Dyno512/OpenVFO/openvfo_nextion_teensy_4.0_eagle_cad/openvfo_nextion_teensy_4.0.png

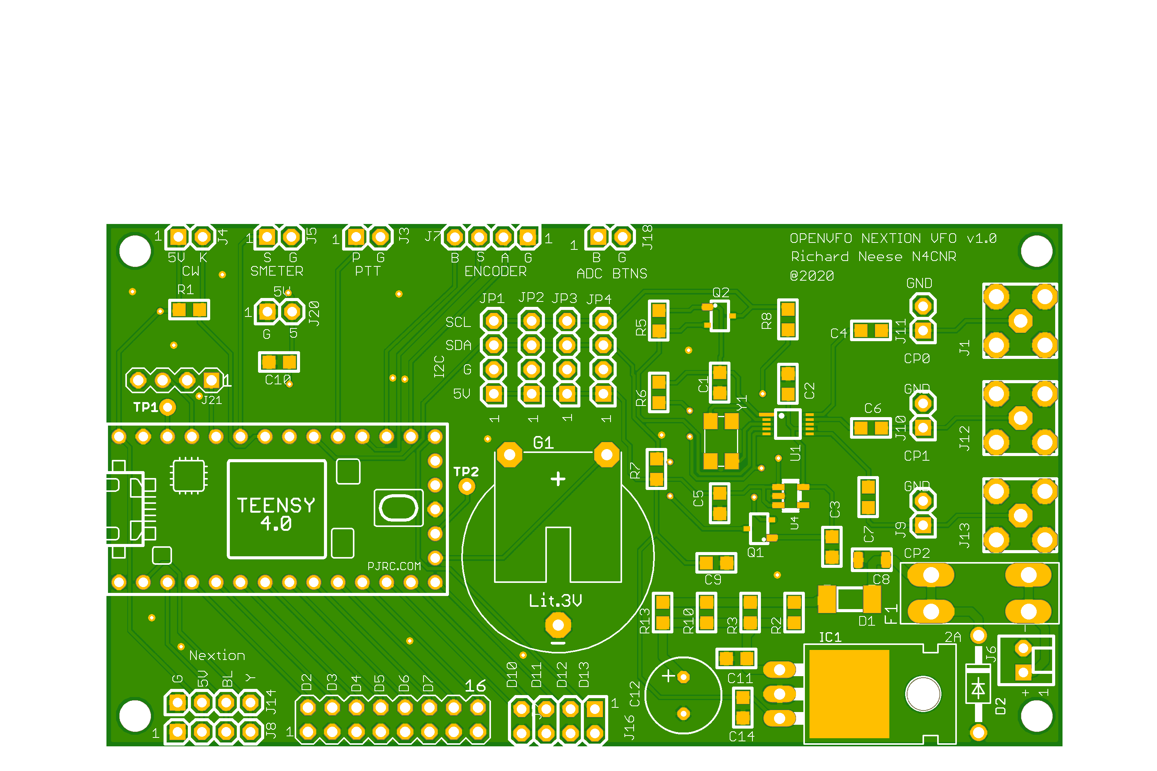
openvfo_nextion_teensy_4.0_eagle_cad/openvfo_nextion_teensy_4.0.png
