Dyno512/OpenVFO/openvfo_nextion_teensy_4.0_eagle_cad/openvfo_nextion_teensy_4.0.dxf

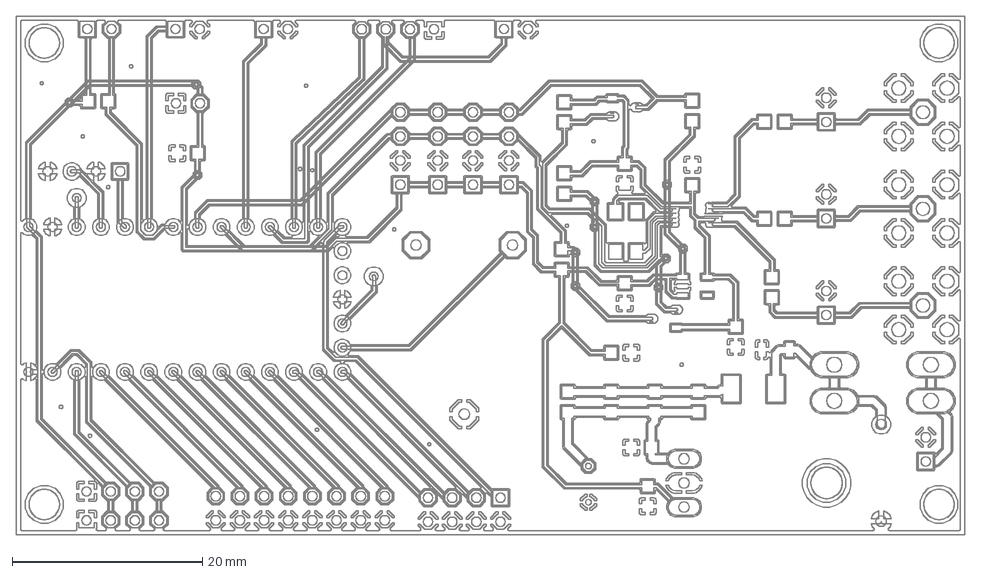
[picture p2: CAD file, 2020-04-06]
openvfo_nextion_teensy_4.0_eagle_cad/openvfo_nextion_teensy_4.0.dxf
99.7 x 54.6 mm
