Dyno512/OpenVFO/openvfo_nextion_teensy_4.0_eagle_cad/openvfo_nextion_teensy_4.0.brd

## EAGLE design openvfo_nextion_teensy_4.0_eagle_cad/openvfo_nextion_teensy_4.0.brd (2020-04-06)

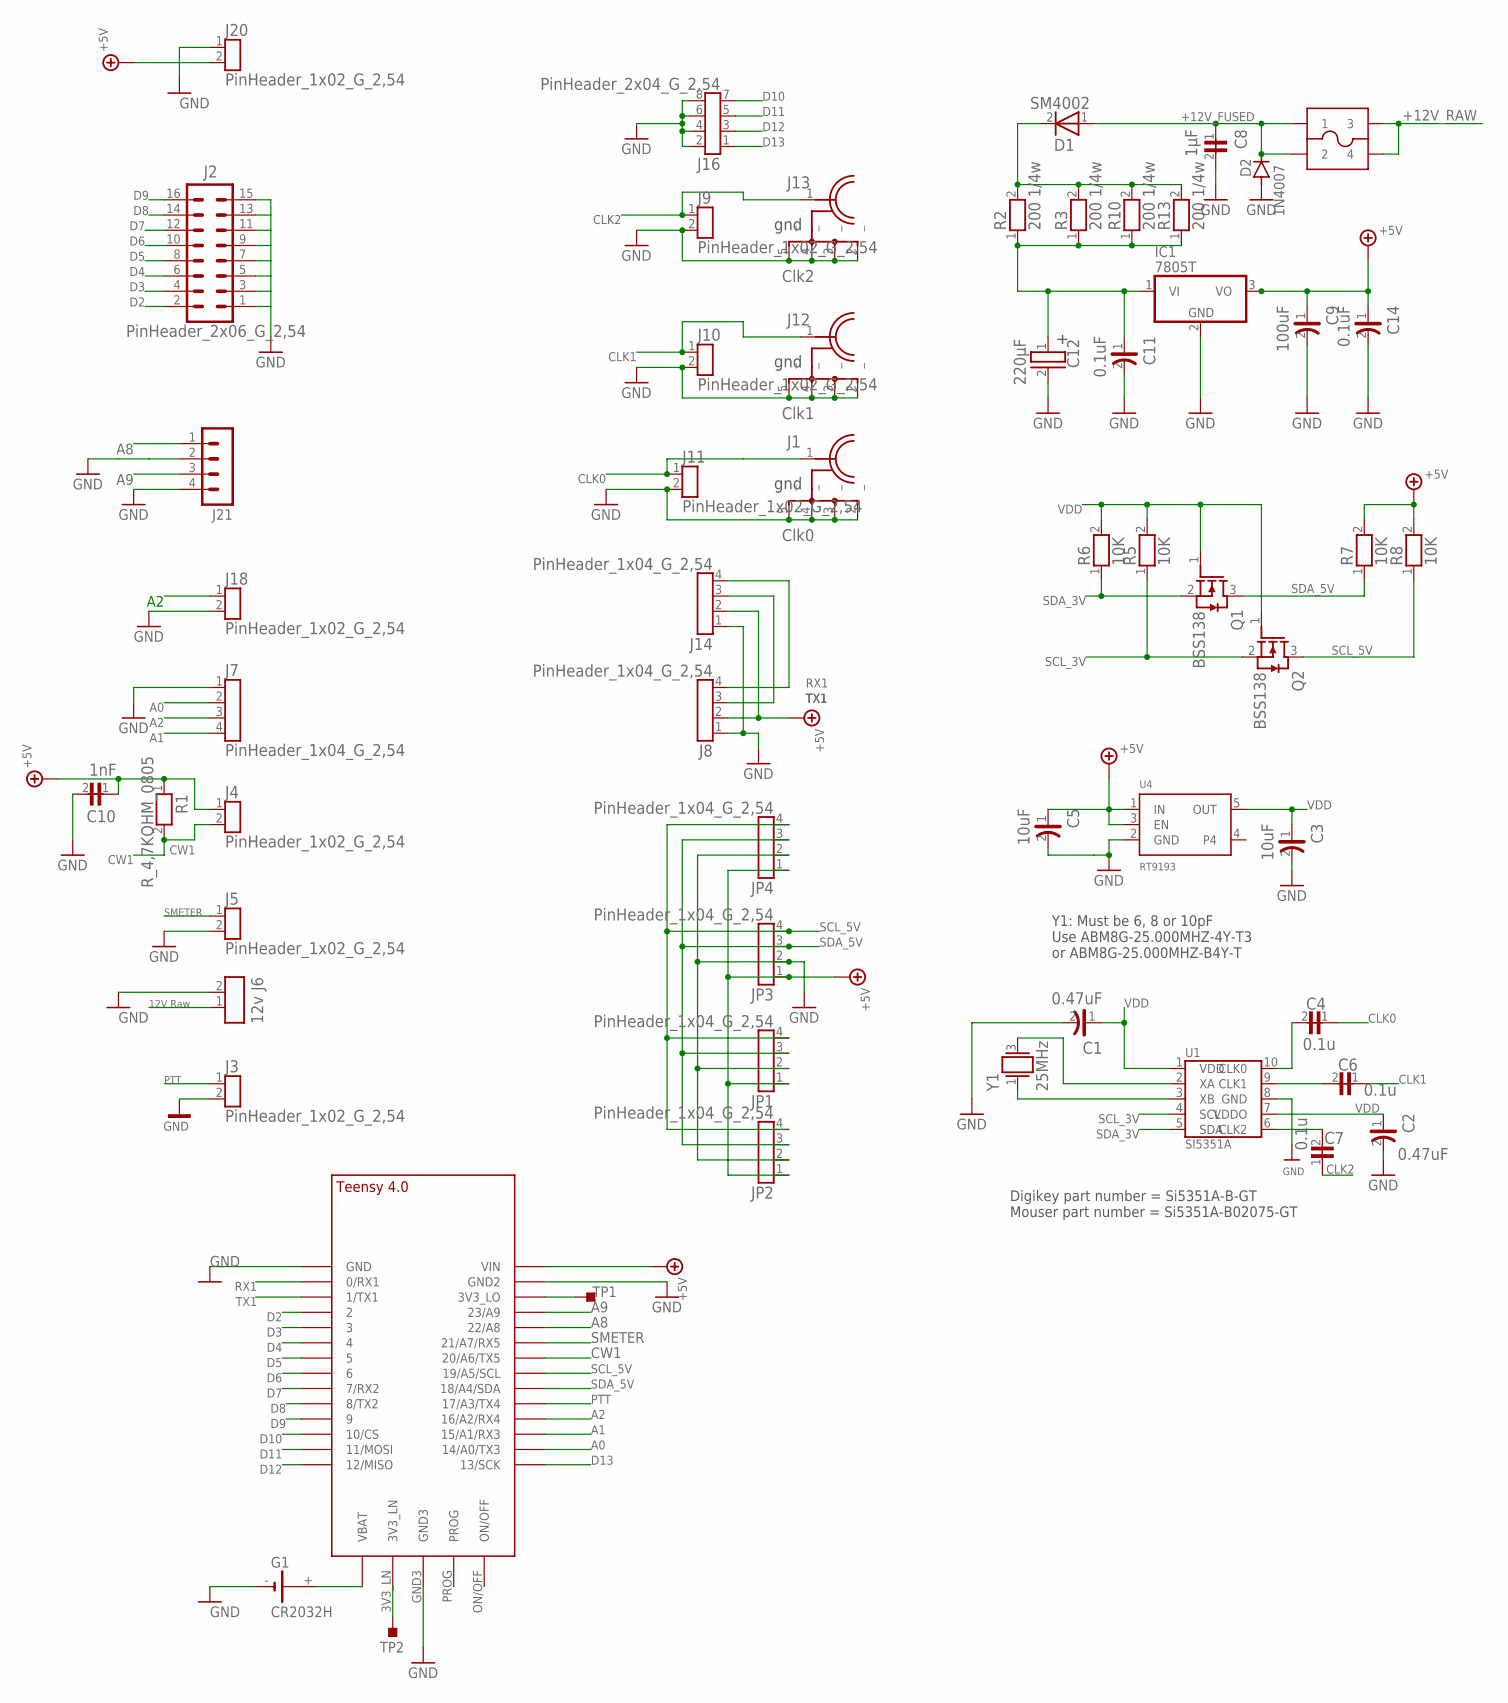
[picture p3: schematic openvfo_nextion_teensy_4.0.sch, Schematic page: 1]

Parts:
C1: 0.47uF; 0805_3
C2: 0.47uF; 0805_4
C3: 10uF; 0805_13
C4: 0.1u; 0805_81
C5: 10uF; 0805_12
C6: 0.1u; 0805_82
C7: 0.1u; 0805_83
C8: 1µF; 1206_84
C9: 100uF; 0805_95
C10: 1nF; 0805_23
C11: 0.1uF; 0805_89
C12: 220µF; D8R3,81_ELKO_104
C14: 0.1uF; 0805_96
D1: SM4002; MELF_85
D2: 1N4007; DO41-10
F1: SMALLFUSE
G1: CR2032H
IC1: 7805T; TO220H
J1: Clk0; SMA-EINBAUBUCHSE_67
J2: PinHeader_2x06_G_2,54; MA08-2
J3: PinHeader_1x02_G_2,54; STIFTLEISTE_1X02_G_2,54_17
J4: PinHeader_1x02_G_2,54; STIFTLEISTE_1X02_G_2,54_18
J5: PinHeader_1x02_G_2,54; STIFTLEISTE_1X02_G_2,54_19
J6: 12v; SL-MTA/2.54/2POL_20
J7: PinHeader_1x04_G_2,54; STIFTLEISTE_1X04_G_2,54_15
J8: PinHeader_1x04_G_2,54; STIFTLEISTE_1X04_G_2,54_22
J9: PinHeader_1x02_G_2,54; STIFTLEISTE_1X02_G_2,54_49
J10: PinHeader_1x02_G_2,54; STIFTLEISTE_1X02_G_2,54_50
J11: PinHeader_1x02_G_2,54; STIFTLEISTE_1X02_G_2,54_51
J12: Clk1; SMA-EINBAUBUCHSE_68
J13: Clk2; SMA-EINBAUBUCHSE_69
J14: PinHeader_1x04_G_2,54; STIFTLEISTE_1X04_G_2,54_70
J16: PinHeader_2x04_G_2,54; STIFTLEISTE_2X04_G_2,54_71
J18: PinHeader_1x02_G_2,54; STIFTLEISTE_1X02_G_2,54_97
J20: PinHeader_1x02_G_2,54; STIFTLEISTE_1X02_G_2,54_137
J21: MA04-1
JP1, JP2, JP3, JP4: PinHeader_1x04_G_2,54; STIFTLEISTE_1X04_G_2,54_14
Q1: BSS138; SOT23/3_7
Q2: BSS138; SOT23/3_8
R1: R_4,7KOHM_0805; 0805_21
R2: 200 1/4w; 0805_142
R3: 200 1/4w; 0805_145
R5: 10K; 0805_5
R6: 10K; 0805_6
R7: 10K; 0805_9
R8: 10K; 0805_10
R10: 200 1/4w; 0805_146
R13: 200 1/4w; 0805_147
TP1, TP2: TESTPOINT_TPS-PAD-036; TESTPOINT_PAD-036
U1: SI5351A; MSOP10/WB3X3/P0,5_0
U4: RT9193; SOT23-5_11
U$1: TEENSY_4.0
Y1: 25MHz; CFPX-104_1

Connections:
+5V: C5.1, C9.1, C10.1, C14.1, IC1.3 (VO), J4.1, J8.2, J14.2, J20.2, JP1.1, JP2.1, JP3.1, JP4.1, R1.1, R7.2, R8.2, U4.1 (IN), U4.3 (EN), U$1.VIN
+12V_FUSED: C8.1, D1.1, D2.C, F1.P$1 (1), F1.P$2 (2)
+12V_RAW: F1.P$3 (3), F1.P$4 (4), J6.1
A0: J7.2, U$1.14/A0 (14/A0/TX3)
A1: J7.4, U$1.15/A1 (15/A1/RX3)
A2: J7.3, J18.1, U$1.16/A2 (16/A2/RX4)
A8: J21.1, U$1.22/A8
A9: J21.3, U$1.23/A9
CLK0: C4.1, J1.1, J11.1
CLK1: C6.1, J10.1, J12.1
CLK2: C7.1, J9.1, J13.1
CW1: J4.2, R1.2, U$1.20/A6 (20/A6/TX5)
D2: J2.2, U$1.2
D3: J2.4, U$1.3/CANTX (3)
D4: J2.6, U$1.4/CANRX (4)
D5: J2.8, U$1.5
D6: J2.10, U$1.6
D7: J2.12, U$1.7 (7/RX2)
D8: J2.14, U$1.8 (8/TX2)
D9: J2.16, U$1.9/CS (9)
D10: J16.7, U$1.10/CS
D11: J16.5, U$1.11/MOSI
D12: J16.3, U$1.12/MISO
D13: J16.1, U$1.13/SCK
GND: C1.2, C2.2, C3.2, C5.2, C8.2, C9.2, C10.2, C11.2, C12.2, C14.2, D2.A, G1.-, IC1.2 (GND), J1.2 (_), J1.3 (_), J1.4 (_), J1.5 (_), J2.1, J2.3, J2.5, J2.7, J2.9, J2.11, J2.13, J2.15, J3.2, J5.2, J6.2, J7.1, J8.1, J9.2, J10.2, J11.2, J12.2 (_), J12.3 (_), J12.4 (_), J12.5 (_), J13.2 (_), J13.3 (_), J13.4 (_), J13.5 (_), J14.1, J16.2, J16.4, J16.6, J16.8, J18.2, J20.1, J21.2, J21.4, JP1.2, JP2.2, JP3.2, JP4.2, U1.8 (GND), U4.2 (GND), U$1.GND, U$1.GND2, U$1.GND3
unnamed: TP2.1, U$1.3V3_LN
unnamed: TP1.1, U$1.3V3_LO
unnamed: G1.+, U$1.VBAT\ (VBAT)
PTT: J3.1, U$1.17/A3 (17/A3/TX4)
RX1: J8.4, J14.4, U$1.0/RX (0/RX1)
SCL_3V: Q2.2, R5.1, U1.4 (SCL)
SCL_5V: JP1.4, JP2.4, JP3.4, JP4.4, Q2.3, R8.1, U$1.19/A5/SCL
SDA_3V: Q1.2, R6.1, U1.5 (SDA)
SDA_5V: JP1.3, JP2.3, JP3.3, JP4.3, Q1.3, R7.1, U$1.18/A4/SDA
SIG$152: C4.2, U1.10 (CLK0)
SIG$153: C6.2, U1.9 (CLK1)
SIG$154: C7.2, U1.6 (CLK2)
SIG$156: U1.2 (XA), Y1.3
SIG$165: U1.3 (XB), Y1.1
SIG$193: C11.1, C12.1, IC1.1 (VI), R2.1, R3.1, R10.1, R13.1
SIG$264: D1.2, R2.2, R3.2, R10.2, R13.2
SMETER: J5.1, U$1.21/A7 (21/A7/RX5)
TX1: J8.3, J14.3, U$1.1/TX (1/TX1)
VDD: C1.1, C2.1, C3.1, Q1.1, Q2.1, R5.2, R6.2, U1.1 (VDD), U1.7 (VDDO), U4.5 (OUT)

Notes on the sheet:
Digikey part number = Si5351A-B-GT
Mouser part number = Si5351A-B02075-GT
Y1: Must be 6, 8 or 10pF
Use ABM8G-25.000MHZ-4Y-T3
or ABM8G-25.000MHZ-B4Y-T
PTT
12V Raw
SMETER

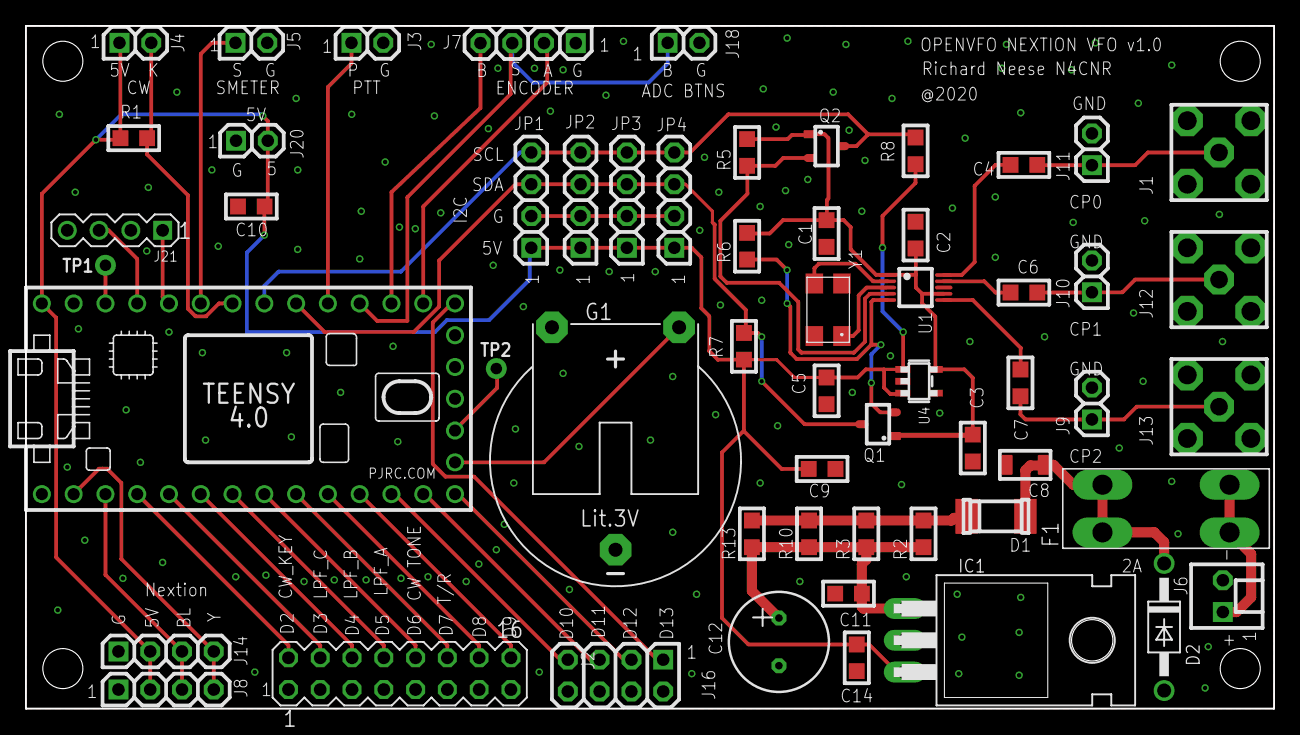
[picture p4: board openvfo_nextion_teensy_4.0.brd from above]

Board: 2 copper layers, 99.7 x 54.6 mm, 57 parts (0 on the bottom side), 44 nets.
