Dyno512/OpenVFO/openvfo/openvfo.h

/*************************************************************************
 OpenVFO header file for C++ 
-----------------------------------------------------------------------------
   This program is free software: you can redistribute it and/or modify
   it under the terms of the GNU General Public License as published by
   the Free Software Foundation, either version 3 of the License, or
   (at your option) any later version.

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
   You should have received a copy of the GNU General Public License
   along with this program.  If not, see <http://www.gnu.org/licenses/>.
**************************************************************************/
#ifndef _OPENVFO_HEADER__
#define _OPENVFO_HEADER__

#include <Arduino.h>  //for Linux, On Linux it is case sensitive.

//==============================================================================
// Compile Option
//==============================================================================
//OpenVFO Board Version
#define OPENVFO_BOARD_VERSION  2         //v1 ~ v4 : 4, v5: 5

//Depending on the type of LCD mounted on the OpenVFO, uncomment one of the options below.
//You must select only one.
//#define OPENVFO_DISPLAY_LCD1602I        //I2C type 16 x 02 LCD
//#define OPENVFO_DISPLAY_LCD2004I        //I2C type 24 x 04 LCD
#define OPENVFO_DISPLAY_NEXTION         //NEXTION LCD

//#define OPENVFO_DISPLAY_NEXTION_SAFE      //Only EEProm Write 770~775
#define I2C_LCD_MASTER_ADDRESS_DEFAULT  0x27     //0x27  //DEFAULT, if Set I2C Address by OpenVFO Manager, read from EEProm

//Select betwen Analog S-Meter and DSP (I2C) Meter
#define USE_I2C_SMETER

#define EXTEND_KEY_GROUP1               //MODE, BAND(-), BAND(+), STEP
//#define EXTEND_KEY_GROUP2             //Numeric (0~9), Point(.), Enter  //Not supported in Version 1.0x

//Custom LPF Filter Mod
//#define USE_CUSTOM_LPF_FILTER           //LPF FILTER MOD

//#define ENABLE_FACTORYALIGN
#define FACTORY_RECOVERY_BOOTUP         //Whether to enter Factory Recovery mode by pressing FKey and turning on power
#define ENABLE_ADCMONITOR               //Starting with Version 1.07, you can read ADC values directly from OpenVFO Manager. So this function is not necessary.

extern byte I2C_LCD_MASTER_ADDRESS;     //0x27  //if Set I2C Address by OpenVFO Manager, read from EEProm
#define SMeterLatency   3               //1 is 0.25 sec

//==============================================================================
// User ON SCREEN MENU Select feather list
//==============================================================================
//Enable all features
#define FN_BAND         1 //592
#define FN_VFO_TOGGLE   1 //78
#define FN_MODE         1 //20
#define FN_RIT          1 //58
#define FN_SPLIT        1 //62
#define FN_IFSHIFT      1 //238
#define FN_ATT          1 //128
#define FN_CW_SPEED     1 //152
#define FN_VFOTOMEM     1 //254
#define FN_MEMTOVFO     1 //188
#define FN_MEMORYKEYER  1 //156
#define FN_WSPR         1 //1044
#define FN_SDRMODE      1 //68
#define FN_CALIBRATION  1 //666
#define FN_CARRIER      1 //382
#define FN_CWCARRIER    1 //346
#define FN_CWTONE       1 //148
#define FN_CWDELAY      1 //98
#define FN_TXCWDELAY    1 //94
#define FN_KEYTYPE      1 //168
#define FN_ADCMONITOR   1 //516
#define FN_TXONOFF      1 //58

/*
//LEAST options Configuration  (88%)
#define FN_BAND         0 //592
#define FN_VFO_TOGGLE   0 //78
#define FN_MODE         0 //20
#define FN_RIT          0 //58
#define FN_SPLIT        0 //62
#define FN_IFSHIFT      0 //238
#define FN_ATT          0 //128
#define FN_CW_SPEED     1 //152
#define FN_VFOTOMEM     0 //254
#define FN_MEMTOVFO     0 //188
#define FN_MEMORYKEYER  1 //156
#define FN_WSPR         0 //1044
#define FN_SDRMODE      1 //68
#define FN_CALIBRATION  1 //666
#define FN_CARRIER      1 //382
#define FN_CWCARRIER    1 //346
#define FN_CWTONE       1 //148
#define FN_CWDELAY      1 //98
#define FN_TXCWDELAY    1 //94
#define FN_KEYTYPE      1 //168
#define FN_ADCMONITOR   1 //516
#define FN_TXONOFF      1 //58
*/

//==============================================================================
// End of User Select Mode and Compil options
//==============================================================================

#ifdef OPENVFO_DISPLAY_LCD1602I
  #define USE_I2C_LCD
#elif defined(OPENVFO_DISPLAY_LCD2004I)
  #define USE_I2C_LCD
#endif

#ifdef OPENVFO_DISPLAY_NEXTION
  #define USE_HW_SERIAL
  #undef ENABLE_ADCMONITOR
  #undef FACTORY_RECOVERY_BOOTUP  
#elif defined(OPENVFO_CONTROL_MCU)
  #define USE_HW_SERIAL
  #undef ENABLE_ADCMONITOR
  #undef FACTORY_RECOVERY_BOOTUP  
#endif


//==============================================================================
// Hardware, Define PIN Usage
//==============================================================================
//#Digital & ANALOG pins OpenVFO Board Teensy 4.0
//D0 &D1 = RX1/TX1/Serial1
#define CW_KEY        (2)   //CW key jack
#define TX_LPF_C      (3)   //Relay 
#define TX_LPF_B      (4)   //Relay
#define TX_LPF_A      (5)   //Relay
#define CW_TONE       (6)	// Generate CW Tone
#define TX_RX         (7)   //Relay
//#define PRE_AMP       (8)  //PreAmp power relay
//#define AGC		      (9)  //Agc circut power relay
//#define MUTE          (10)  //Mute circut power relay
//#define AMP_KEY       (11) //AMP_KEY relay for keying ext amp
//#define ANT_SEL       (12) //Antenna 1/2 Select Relay
//#define DIGITAL_SPARE  (13)//LED pin 
//#Analog to be converted to digital
#define ENC_A         (A0) //D14
#define ENC_B         (A1) //D15
#define FBUTTON       (A2) //D16
#define PTT           (A3) //D17
//*Note: A4/D18/SDA0, A5/D19/SCL0 are wired to the Si5351 as I2C interface 
#define ANALOG_KEYER  (A6) //D20
#define ANALOG_SMETER (A7) //D21
//#define ANALOG_DIGITAL_SPARE  (A8) //D22
//#define ANALOG_DIGITAL_SPARE  (A9) //D23
//^Note pins from underside of Teensy 4.0
// OpenVFO PRO Board 
// Uncomment them as needed for the pro board
//#define ANALOG_DIGITAL_SPARE  (A10) //D24
//#define ANALOG_DIGITAL_SPARE  (A11) //D25
//#define ANALOG_DIGITAL_SPARE  (A12) //D26
//#define ANALOG_DIGITAL_SPARE  (A13) //D27
//#define DIGITAL_SPARE  (28)
//#define DIGITAL_SPARE  (29)
//#define DIGITAL_SPARE  (30)
//#define DIGITAL_SPARE  (31)
//#define DIGITAL_SPARE  (32)
//#define DIGITAL_SPARE  (33)

//******************************************************
//DSP (I2C) Meter 
//******************************************************
//S-Meter Address
#define I2CMETER_ADDR     0x58
//VALUE TYPE============================================
//Signal
#define I2CMETER_CALCS    0x59 //Calculated Signal Meter
#define I2CMETER_UNCALCS  0x58 //Uncalculated Signal Meter

//Power
#define I2CMETER_CALCP    0x57 //Calculated Power Meter
#define I2CMETER_UNCALCP  0x56 //UnCalculated Power Meter

//SWR
#define I2CMETER_CALCR    0x55 //Calculated SWR Meter
#define I2CMETER_UNCALCR  0x54 //Uncalculated SWR Meter

//==============================================================================
// for public, Variable, functions
//==============================================================================
#define WSPR_BAND_COUNT 3
#define TX_SSB          0
#define TX_CW           1
#define printLineF1(x) (printLineF(1, x))
#define printLineF2(x) (printLineF(0, x))

//0x00 : None, 0x01 : MODE, 0x02:BAND+, 0x03:BAND-, 0x04:TUNE_STEP, 0x05:VFO Toggle, 0x06:SplitOn/Off, 0x07:TX/ON-OFF,  0x08:SDR Mode On / Off, 0x09:Rit Toggle
#define FUNCTION_KEY_ADC  80  //MODE, BAND(-), BAND(+), STEP
#define FKEY_PRESS      0x78
#define FKEY_MODE       0x01
#define FKEY_BANDUP     0x02
#define FKEY_BANDDOWN   0x03
#define FKEY_STEP       0x04
#define FKEY_VFOCHANGE  0x05
#define FKEY_SPLIT      0x06
#define FKEY_TXOFF      0x07
#define FKEY_SDRMODE    0x08
#define FKEY_RIT        0x09

#define FKEY_ENTER      0x0A
#define FKEY_POINT      0x0B
#define FKEY_DELETE     0x0C
#define FKEY_CANCEL     0x0D

#define FKEY_NUM0       0x10
#define FKEY_NUM1       0x11
#define FKEY_NUM2       0x12
#define FKEY_NUM3       0x13
#define FKEY_NUM4       0x14
#define FKEY_NUM5       0x15
#define FKEY_NUM6       0x16
#define FKEY_NUM7       0x17
#define FKEY_NUM8       0x18
#define FKEY_NUM9       0x19

#define FKEY_TYPE_MAX   0x1F

extern uint8_t SI5351BX_ADDR;     //change typical -> variable at Version 1.097, address read from eeprom, default value is 0x60
                                  //EEProm Address : 63
extern unsigned long frequency;
extern byte WsprMSGCount;
extern byte sMeterLevels[9];
extern int currentSMeter;         //ADC Value for S.Meter
extern byte scaledSMeter;         //Calculated S.Meter Level

extern byte KeyValues[16][3];     //Set : Start Value, End Value, Key Type, 16 Set (3 * 16 = 48)
extern byte TriggerBySW;   //Action Start from Nextion LCD, Other MCU

extern void printLine1(const char *c);
extern void printLine2(const char *c);
extern void printLineF(char linenmbr, const __FlashStringHelper *c);
extern void printLineFromEEPRom(char linenmbr, char lcdColumn, byte eepromStartIndex, byte eepromEndIndex, char offsetType);
extern byte delay_background(unsigned delayTime, byte fromType);
extern int btnDown(void);
extern char c[30];
extern char b[30];
extern int enc_read(void);
extern void si5351bx_init(void);
extern void si5351bx_setfreq(uint8_t clknum, uint32_t fout);
extern void si5351_set_calibration(int32_t cal);
extern void initOscillators(void);
extern void Set_WSPR_Param(void);
extern void TXSubFreq(unsigned long P2);

extern void startTx(byte txMode, byte isDisplayUpdate);
extern void stopTx(void);
extern void setTXFilters(unsigned long freq);

extern void SendWSPRManage(void);
extern char byteToChar(byte srcByte);
extern void DisplayCallsign(byte callSignLength);
extern void DisplayVersionInfo(const char* fwVersionInfo);

//I2C Signal Meter,
extern int GetI2CSmeterValue(int valueType);  //openvfo_ui.ino

#endif    //end of if header define
