Dyno512/OpenVFO/openvfo/lcd-screens/openvfo_lcd_1602.ino

/*************************************************************************
  KD8CEC's uBITX Display Routine for LCD1602 Parrel
  1.This is the display code for the default LCD mounted in uBITX.
  2.Some functions moved from uBITX_Ui.
-----------------------------------------------------------------------------
   This program is free software: you can redistribute it and/or modify
   it under the terms of the GNU General Public License as published by
   the Free Software Foundation, either version 3 of the License, or
   (at your option) any later version.

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
**************************************************************************/
#include "openvfo.h"
#include "openvfo_lcd.h"

//========================================================================
//Begin of I2CTinyLCD Library 
//========================================================================
#ifdef OPENVFO_DISPLAY_LCD1602I
#include <Wire.h>
/*************************************************************************
  I2C Tiny LCD Library
  Referecnce Source : LiquidCrystal_I2C.cpp // Based on the work by DFRobot
  KD8CEC

  This source code is modified version for small program memory 
  from Arduino LiquidCrystal_I2C Library

  I wrote this code myself, so there is no license restriction. 
  So this code allows anyone to write with confidence.
  But keep it as long as the original author of the code.
  Ian KD8CEC
**************************************************************************/
#define OPENVFO_DISPLAY_LCD1602_BASE

#define En B00000100  // Enable bit
#define Rw B00000010  // Read/Write bit
#define Rs B00000001  // Register select bit

#define LCD_Command(x)  (LCD_Send(x, 0))
#define LCD_Write(x)    (LCD_Send(x, Rs))

uint8_t _Addr;
uint8_t _displayfunction;
uint8_t _displaycontrol;
uint8_t _displaymode;
uint8_t _numlines;
uint8_t _cols;
uint8_t _rows;
uint8_t _backlightval;

#define printIIC(args)  Wire.write(args)

void expanderWrite(uint8_t _data)
{
  Wire.beginTransmission(_Addr);
  printIIC((int)(_data) | _backlightval);
  Wire.endTransmission();   
}

void pulseEnable(uint8_t _data){
  expanderWrite(_data | En);  // En high
  delayMicroseconds(1);       // enable pulse must be >450ns
  
  expanderWrite(_data & ~En); // En low
  delayMicroseconds(50);      // commands need > 37us to settle
}

void write4bits(uint8_t value) 
{
  expanderWrite(value);
  pulseEnable(value);
}

void LCD_Send(uint8_t value, uint8_t mode)
{
  uint8_t highnib=value&0xf0;
  uint8_t lownib=(value<<4)&0xf0;
       write4bits((highnib)|mode);
  write4bits((lownib)|mode); 
}


// Turn the (optional) backlight off/on
void noBacklight(void) {
  _backlightval=LCD_NOBACKLIGHT;
  expanderWrite(0);
}

void backlight(void) {
  _backlightval=LCD_BACKLIGHT;
  expanderWrite(0);
}

void LCD1602_Init()
{
  //I2C Init
  _Addr = I2C_LCD_MASTER_ADDRESS;
  _cols = 16;
  _rows = 2;
  _backlightval = LCD_NOBACKLIGHT;
  Wire.begin();

  delay(50);
  
  // Now we pull both RS and R/W low to begin commands
  expanderWrite(_backlightval); // reset expanderand turn backlight off (Bit 8 =1)
  delay(1000);
      //put the LCD into 4 bit mode
  // this is according to the hitachi HD44780 datasheet
  // figure 24, pg 46
  
    // we start in 8bit mode, try to set 4 bit mode
   write4bits(0x03 << 4);
   delayMicroseconds(4500); // wait min 4.1ms
   
   // second try
   write4bits(0x03 << 4);
   delayMicroseconds(4500); // wait min 4.1ms
   
   // third go!
   write4bits(0x03 << 4); 
   delayMicroseconds(150);
   
   // finally, set to 4-bit interface
   write4bits(0x02 << 4); 

  // finally, set # lines, font size, etc.
  LCD_Command(LCD_FUNCTIONSET | LCD_4BITMODE | LCD_1LINE | LCD_5x8DOTS | LCD_2LINE);  

  // turn the display on with no cursor or blinking default
  LCD_Command(LCD_DISPLAYCONTROL | LCD_DISPLAYON | LCD_CURSOROFF | LCD_BLINKOFF);

  // clear it off
  LCD_Command(LCD_CLEARDISPLAY);  // clear display, set cursor position to zero
  //delayMicroseconds(2000);  // this command takes a long time!
  delayMicroseconds(1000);  // this command takes a long time!

  LCD_Command(LCD_ENTRYMODESET | LCD_ENTRYLEFT | LCD_ENTRYSHIFTDECREMENT);

  backlight();
}

#endif
//========================================================================
//End of I2CTinyLCD Library by KD8CEC
//========================================================================


//========================================================================
// 16 X 02 LCD Routines
//Begin of Display Base Routines (Init, printLine..)
//========================================================================
#ifdef OPENVFO_DISPLAY_LCD1602_BASE

//SWR GRAPH,  DrawMeter and drawingMeter Logic function by VK2ETA 
#define OPTION_SKINNYBARS

char c[30], b[30];
char printBuff[2][17];  //mirrors what is showing on the two lines of the display


void LCD_Print(const char *c) 
{
  for (uint8_t i = 0; i < strlen(c); i++)
  {
    if (*(c + i) == 0x00) return;
    LCD_Write(*(c + i));
  }
}

void LCD_SetCursor(uint8_t col, uint8_t row)
{
  LCD_Command(LCD_SETDDRAMADDR | (col + row * 0x40));  //0 : 0x00, 1 : 0x40, only for 16 x 2 lcd
}

void LCD_CreateChar(uint8_t location, uint8_t charmap[]) 
{
  location &= 0x7; // we only have 8 locations 0-7
  LCD_Command(LCD_SETCGRAMADDR | (location << 3));
  for (int i=0; i<8; i++)
    LCD_Write(charmap[i]);
}

void LCD_Init(void)
{
  LCD1602_Init();  
  initMeter(); //for Meter Display
}

// The generic routine to display one line on the LCD 
void printLine(unsigned char linenmbr, const char *c) {
  if ((displayOption1 & 0x01) == 0x01)
    linenmbr = (linenmbr == 0 ? 1 : 0); //Line Toggle
  if (strcmp(c, printBuff[linenmbr])) {     // only refresh the display when there was a change
    LCD_SetCursor(0, linenmbr);             // place the cursor at the beginning of the selected line
    LCD_Print(c);
    strcpy(printBuff[linenmbr], c);

    for (byte i = strlen(c); i < 16; i++) { // add white spaces until the end of the 16 characters line is reached
      LCD_Write(' ');
    }
  }
}

void printLineF(char linenmbr, const __FlashStringHelper *c)
{
  int i;
  char tmpBuff[17];
  PGM_P p = reinterpret_cast<PGM_P>(c);  

  for (i = 0; i < 17; i++){
    unsigned char fChar = pgm_read_byte(p++);
    tmpBuff[i] = fChar;
    if (fChar == 0)
      break;
  }

  printLine(linenmbr, tmpBuff);
}

#define LCD_MAX_COLUMN 16
void printLineFromEEPRom(char linenmbr, char lcdColumn, byte eepromStartIndex, byte eepromEndIndex, char offsetTtype) {
  if ((displayOption1 & 0x01) == 0x01)
    linenmbr = (linenmbr == 0 ? 1 : 0); //Line Toggle
  
  LCD_SetCursor(lcdColumn, linenmbr);

  for (byte i = eepromStartIndex; i <= eepromEndIndex; i++)
  {
    if (++lcdColumn <= LCD_MAX_COLUMN)
      LCD_Write(EEPROM.read((offsetTtype == 0 ? USER_CALLSIGN_DAT : WSPR_MESSAGE1) + i));
    else
      break;
  }
  
  for (byte i = lcdColumn; i < 16; i++) //Right Padding by Space
      LCD_Write(' ');
}

//  short cut to print to the first line
void printLine1(const char *c)
{
  printLine(1,c);
}
//  short cut to print to the first line
void printLine2(const char *c)
{
  printLine(0,c);
}

void clearLine2()
{
  printLine2("");
  line2DisplayStatus = 0;
}

//  short cut to print to the first line
void printLine1Clear(){
  printLine(1,"");
}
//  short cut to print to the first line
void printLine2Clear(){
  printLine(0, "");
}

void printLine2ClearAndUpdate(){
  printLine(0, "");
  line2DisplayStatus = 0;  
  updateDisplay();
}

//==================================================================================
//End of Display Base Routines
//==================================================================================


//==================================================================================
//Begin of User Interface Routines
//==================================================================================

//Main Display
// this builds up the top line of the display with frequency and mode
void updateDisplay() {
  // tks Jack Purdum W8TEE
  // replaced fsprint commmands by str commands for code size reduction
  // replace code for Frequency numbering error (alignment, point...) by KD8CEC
  int i;
  unsigned long tmpFreq = frequency; //
  
  memset(c, 0, sizeof(c));

  if (inTx){
    if (isCWAutoMode == 2) {
      for (i = 0; i < 4; i++)
        c[3-i] = (i < autoCWSendReservCount ? byteToChar(autoCWSendReserv[i]) : ' ');

      //display Sending Index
      c[4] = byteToChar(sendingCWTextIndex);
      c[5] = '=';
    }
    else {
      if (cwTimeout > 0)
        strcpy(c, "   CW:");
      else
        strcpy(c, "   TX:");
    }
  }
  else {
    if (ritOn)
      strcpy(c, "RIT ");
    else {
      if (cwMode == 0)
      {
        if (isUSB)
          strcpy(c, "USB ");
        else
          strcpy(c, "LSB ");
      }
      else if (cwMode == 1)
      {
          strcpy(c, "CWL ");
      }
      else
      {
          strcpy(c, "CWU ");
      }
    }
    if (vfoActive == VFO_A) // VFO A is active
      strcat(c, "A:");
    else
      strcat(c, "B:");
  }

  //Fixed by Mitani Massaru (JE4SMQ)
  if (isShiftDisplayCWFreq == 1)
  {
    if (cwMode == 1)        //CWL
        tmpFreq = tmpFreq - sideTone + shiftDisplayAdjustVal;
    else if (cwMode == 2)   //CWU
        tmpFreq = tmpFreq + sideTone + shiftDisplayAdjustVal;
  }

  //display frequency
  for (int i = 15; i >= 6; i--) {
    if (tmpFreq > 0) {
      if (i == 12 || i == 8) c[i] = '.';
      else {
        c[i] = tmpFreq % 10 + 0x30;
        tmpFreq /= 10;
      }
    }
    else
      c[i] = ' ';
  }

  //remarked by KD8CEC
  //already RX/TX status display, and over index (16 x 2 LCD)
  //if (inTx)
  //  strcat(c, " TX");
  printLine(1, c);

  byte diplayVFOLine = 1;
  if ((displayOption1 & 0x01) == 0x01)
    diplayVFOLine = 0;

  if ((vfoActive == VFO_A && ((isDialLock & 0x01) == 0x01)) ||
    (vfoActive == VFO_B && ((isDialLock & 0x02) == 0x02))) {
    LCD_SetCursor(5,diplayVFOLine);
    LCD_Write((uint8_t)0);
  }
  else if (isCWAutoMode == 2){
    LCD_SetCursor(5,diplayVFOLine);
    LCD_Write(0x7E);
  }
  else
  {
    LCD_SetCursor(5,diplayVFOLine);
    LCD_Write(':');
  }
}



char line2Buffer[17];
//KD8CEC 200Hz ST
//L14.150 200Hz ST
//U14.150 +150khz
int freqScrollPosition = 0;

//Example Line2 Optinal Display
//immediate execution, not call by scheulder
//warning : unused parameter 'displayType' <-- ignore, this is reserve
void updateLine2Buffer(char displayType)
{
  unsigned long tmpFreq = 0;
  if (ritOn)
  {
    strcpy(line2Buffer, "RitTX:");

    //display frequency
    tmpFreq = ritTxFrequency;

    //Fixed by Mitani Massaru (JE4SMQ)
    if (isShiftDisplayCWFreq == 1)
    {
      if (cwMode == 1)        //CWL
          tmpFreq = tmpFreq - sideTone + shiftDisplayAdjustVal;
      else if (cwMode == 2)   //CWU
          tmpFreq = tmpFreq + sideTone + shiftDisplayAdjustVal;
    }
    
    for (int i = 15; i >= 6; i--) {
      if (tmpFreq > 0) {
        if (i == 12 || i == 8) line2Buffer[i] = '.';
        else {
          line2Buffer[i] = tmpFreq % 10 + 0x30;
          tmpFreq /= 10;
        }
      }
      else
        line2Buffer[i] = ' ';
    }

    return;
  } //end of ritOn display

  //other VFO display
  if (vfoActive == VFO_B)
  {
    tmpFreq = vfoA;
  }
  else 
  {
    tmpFreq = vfoB;
  }

  // EXAMPLE 1 & 2
  //U14.150.100
  //display frequency
  for (int i = 9; i >= 0; i--) {
    if (tmpFreq > 0) {
      if (i == 2 || i == 6) line2Buffer[i] = '.';
      else {
        line2Buffer[i] = tmpFreq % 10 + 0x30;
        tmpFreq /= 10;
      }
    }
    else
      line2Buffer[i] = ' ';
  }

  //EXAMPLE #1
  if ((displayOption1 & 0x04) == 0x00)  //none scroll display
    line2Buffer[6] = 'M';
  else
  {
    //example #2
    if (freqScrollPosition++ > 18)    //none scroll display time
    {
      line2Buffer[6] = 'M';
      if (freqScrollPosition > 25)
        freqScrollPosition = -1;
    }
    else                              //scroll frequency 
    {
      line2Buffer[10] = 'H';
      line2Buffer[11] = 'z';
  
      if (freqScrollPosition < 7)   
      {
        for (int i = 11; i >= 0; i--)
          if (i - (7 - freqScrollPosition) >= 0)
            line2Buffer[i] = line2Buffer[i - (7 - freqScrollPosition)];
          else
            line2Buffer[i] = ' ';
      }
      else
      {
        for (int i = 0; i < 11; i++)
          if (i + (freqScrollPosition - 7) <= 11)
            line2Buffer[i] = line2Buffer[i + (freqScrollPosition - 7)];
          else
            line2Buffer[i] = ' ';
      }
    }
  } //scroll
  
  line2Buffer[7] = ' ';
  
  if (isIFShift)
  {
//    if (isDirectCall == 1)
//      for (int i = 0; i < 16; i++)
//        line2Buffer[i] = ' ';
      
      //IFShift Offset Value 
    line2Buffer[8] = 'I';
    line2Buffer[9] = 'F';

    line2Buffer[10] = ifShiftValue >= 0 ? '+' : 0;
    line2Buffer[11] = 0;
    line2Buffer[12] = ' ';
  
    //11, 12, 13, 14, 15
    memset(b, 0, sizeof(b));
    ltoa(ifShiftValue, b, DEC);
    strncat(line2Buffer, b, 5);
    
    //if (isDirectCall == 1)  //if call by encoder (not scheduler), immediate print value
    printLine2(line2Buffer);    
  }       // end of display IF
  else    // step & Key Type display
  {
    //if (isDirectCall != 0)
    //  return;

    memset(&line2Buffer[8], ' ', 8);
    //Step
    long tmpStep = arTuneStep[tuneStepIndex -1];
    
    byte isStepKhz = 0;
    if (tmpStep >= 1000)
    {
      isStepKhz = 2;
    }
      
    for (int i = 10; i >= 8 - isStepKhz; i--) {
      if (tmpStep > 0) {
          line2Buffer[i + isStepKhz] = tmpStep % 10 + 0x30;
          tmpStep /= 10;
      }
      else
        line2Buffer[i +isStepKhz] = ' ';
    }

    if (isStepKhz == 0)
    {
      line2Buffer[11] = 'H';
      line2Buffer[12] = 'z';
    }
  
    line2Buffer[13] = ' ';
    
    //Check CW Key cwKeyType = 0; //0: straight, 1 : iambica, 2: iambicb
    if (sdrModeOn == 1)
    {
      line2Buffer[13] = 'S';
      line2Buffer[14] = 'D';
      line2Buffer[15] = 'R';
    }
    else if (cwKeyType == 0)
    {
      line2Buffer[14] = 'S';
      line2Buffer[15] = 'T';
    }
    else if (cwKeyType == 1)
    {
      line2Buffer[14] = 'I';
      line2Buffer[15] = 'A';
    }
    else
    {
      line2Buffer[14] = 'I';
      line2Buffer[15] = 'B';
    }    
  }
}

//meterType : 0 = S.Meter, 1 : P.Meter
void DisplayMeter(byte meterType, byte meterValue, char drawPosition)
{
  if (meterType == 0 || meterType == 1 || meterType == 2)
  {
    drawMeter(meterValue);
    int lineNumber = 0;
    if ((displayOption1 & 0x01) == 0x01)
      lineNumber = 1;
    
    LCD_SetCursor(drawPosition, lineNumber);
  
    LCD_Write(lcdMeter[0]);
    LCD_Write(lcdMeter[1]);
    LCD_Write(lcdMeter[2]);
  }
}

char checkCount = 0;
char checkCountSMeter = 0;

void idle_process()
{
  //space for user graphic display
  if (menuOn == 0)
  {
    if ((displayOption1 & 0x10) == 0x10)    //always empty topline
      return;
      
    //if line2DisplayStatus == 0 <-- this condition is clear Line, you can display any message
    if (line2DisplayStatus == 0 || (((displayOption1 & 0x04) == 0x04) && line2DisplayStatus == 2)) {
      if (checkCount++ > 1)
      {
        updateLine2Buffer(0); //call by scheduler
        printLine2(line2Buffer);
        line2DisplayStatus = 2;
        checkCount = 0;
      }
    }

    //S-Meter Display
    if (((displayOption1 & 0x08) == 0x08 && (sdrModeOn == 0)) && (++checkCountSMeter > SMeterLatency))
    {
      int newSMeter;

#ifdef USE_I2C_SMETER 
    scaledSMeter = GetI2CSmeterValue(I2CMETER_CALCS);
#else
      //VK2ETA S-Meter from MAX9814 TC pin / divide 4 by KD8CEC for reduce EEPromSize
      newSMeter = analogRead(ANALOG_SMETER) / 4;
  
      //Faster attack, Slower release
      //currentSMeter = (newSMeter > currentSMeter ? ((currentSMeter * 3 + newSMeter * 7) + 5) / 10 : ((currentSMeter * 7 + newSMeter * 3) + 5) / 10) / 4;
      currentSMeter = newSMeter;

      scaledSMeter = 0;
      for (byte s = 8; s >= 1; s--) {
        if (currentSMeter > sMeterLevels[s]) {
          scaledSMeter = s;
          break;
        }
      }
#endif  
  
      DisplayMeter(0, scaledSMeter, 13);
      checkCountSMeter = 0; //Reset Latency time
    }   //end of S-Meter
    
  }
}

//AutoKey LCD Display Routine
void Display_AutoKeyTextIndex(byte textIndex)
{
  byte diplayAutoCWLine = 0;
  
  if ((displayOption1 & 0x01) == 0x01)
    diplayAutoCWLine = 1;
  LCD_SetCursor(0, diplayAutoCWLine);
  LCD_Write(byteToChar(textIndex));
  LCD_Write(':');
}

void DisplayCallsign(byte callSignLength)
{
  printLineFromEEPRom(0, 0, 0, userCallsignLength -1, 0); //eeprom to lcd use offset (USER_CALLSIGN_DAT)
  //delay(500);
}

void DisplayVersionInfo(const __FlashStringHelper * fwVersionInfo)
{
  printLineF(1, fwVersionInfo);
}

#endif
