Dyno512/OpenVFO/(commit log)

2020-04-06 Added new files
    [openvfo_nextion_teensy_4.0.brd, openvfo_nextion_teensy_4.0.dxf, openvfo_nextion_teensy_4.0.sch]
2020-04-07 Update openvfo.h
    Updated the pinout for use with the teensy 4.0 and OpenVFO
2020-04-17 working on openvfo
    working on serial driver
2020-04-30 working on serial display driver
    working to replace softserial with hardware serial
    [openvfo_lcd_nextion.ino]
